codeshelf/MOUNTA/MOUNTA.45/production files/MOUNTA.45 LASERCUT README.docx

MOUNTA.45 LASERCUT README

Vendor: Ponoko

File: MOUNTA.45_X40_P2_0.193BLACK_DELRIN.eps OR MOUNTA.45_X81_P3_0.193BLACK_DELRIN.eps

Material: Delrin, Black

Thickness: 0.193 inches

Yield: 40 OR 81
