codeshelf/MOUNTA/MOUNTA.90/production files/MOUNTA.90 LASERCUT README.docx

MOUNTA.90 LASERCUT README

Vendor: Ponoko

Files: MOUNTA.90_X42_P2_0.193WHITE_DELRIN.eps OR MOUNTA.90_X91_P3_0.193WHITE_DELRIN.eps

Material: Delrin, White

Thickness: 0.193 inches

Yield: 42 OR 91
