codeshelf/MOUNTA/MOUNTA.45/production files/MOUNTA.45.BOM.xlsx

 | Product Name: | Mounting Bracket A 45 degree (VER 1.1 REV A) |  | Tag: | MOUNTA.45.v1.1
 | Product Number: | MOUNTA.45 |  | Date: | 2015-05-21
 |  |  |  | Last Updated: | 2016-01-28
Qty | Name | Description | Drawing/Part No. | Tag | Date | Supplier | Notes
2 | MOUNTA.45 | 45Degree (vertical) mounting bracket, lasercut 5mm Delrin | MOUNTA.45 | MOUNTA.45.v1.1 | 2016-01-28 | Ponoko | See README for production details
