codeshelf/MOUNTA/MOUNTA.90/production files/MOUNTA.90.BOM.xlsx

 | Product Name: | Mounting Bracket A 90 degree (VER 1.1 REV A) |  | Tag: | MOUNTA.90.v1.1
 | Product Number: | MOUNTA.90 |  | Date: | 2015-05-21
 |  |  |  | Last Updated: | 2016-01-28
Qty | Name | Description | Drawing/Part No. | Tag | Date | Supplier | Notes
2 | MOUNTA.90 | 90 Degree (vertical) mounting bracket, lasercut 5mm Delrin | MOUNTA.90 | v1.1 | 2016-01-28 | Ponoko | See README for production details
