codeshelf/MOUNTA/MOUNTA.45/Design Files/MOUNTA.V1.1.45.SLDPRT

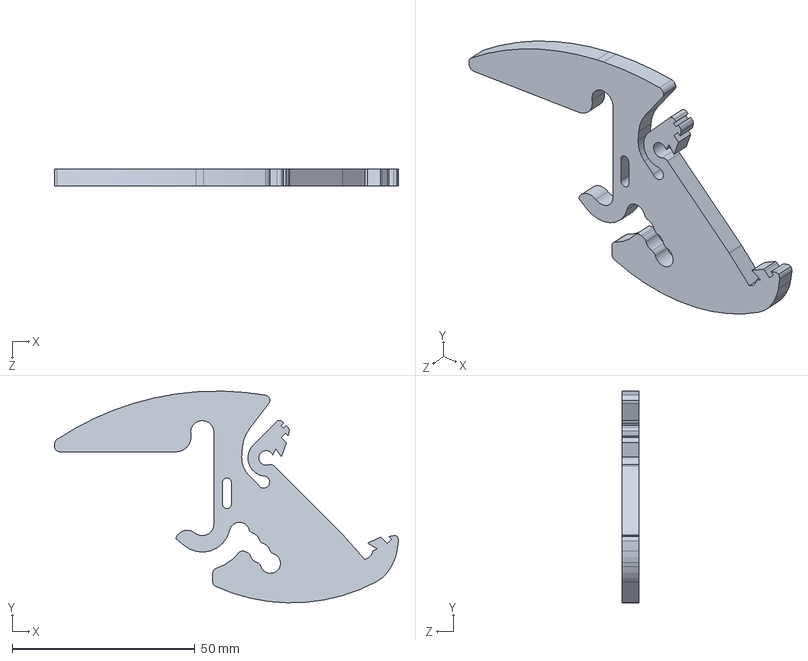
[picture p2: CAD file, 2016-02-16]
MOUNTA.45/Design Files/MOUNTA.V1.1.45.SLDPRT
94.1 x 57.9 x 4.76 mm
