codeshelf/MOUNTA/MOUNTA.90/Design Files/MOUNTA.V1.1.90.SLDPRT

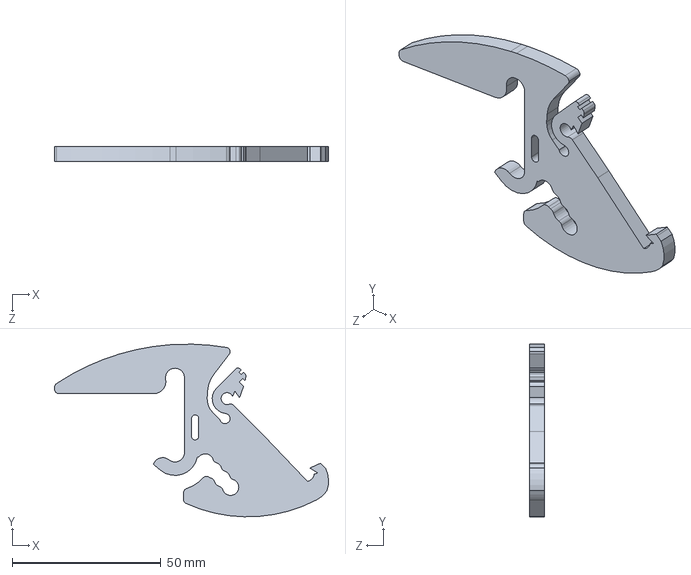
[picture p3: CAD file, 2016-01-27]
MOUNTA.90/Design Files/MOUNTA.V1.1.90.SLDPRT
91.9 x 57.9 x 4.90 mm
