codeshelf/MOUNTA/(list of files, cad)

Other CAD files:
MOUNTA.45/Design Files/MOUNTA.V1.1.45.DXF
MOUNTA.45/Design Files/MOUNTA.V1.1.45.SLDDRW
