codeshelf/MOUNTA/MOUNTA.45/production files/MOUNTA.V1.1.45.PDF

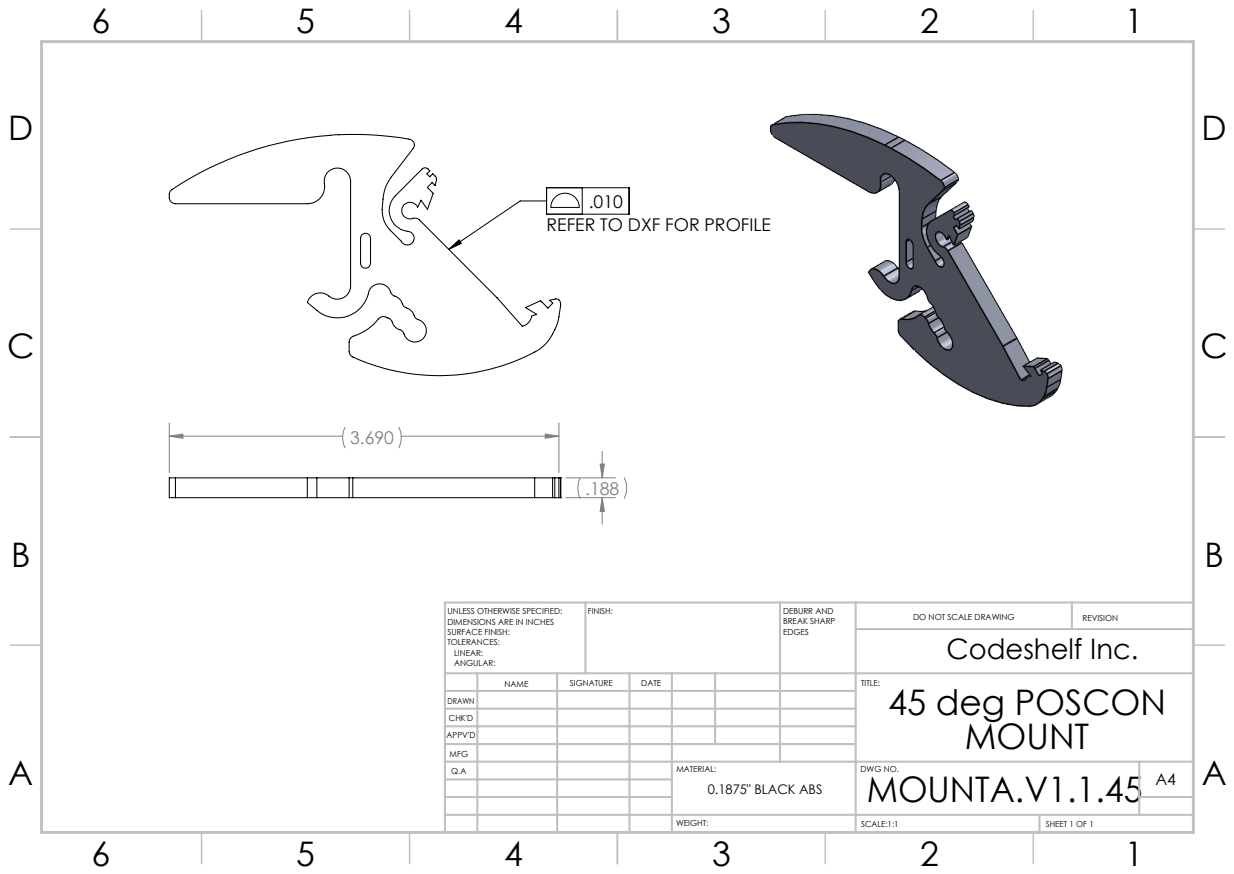
[picture p4: page 1]
FINISH:; DEBURR AND; BREAK SHARP; DO NOT SCALE DRAWING; REVISION; SCALE:1:1; SHEET 1 OF 1; Codeshelf Inc.

REFER TO DXF FOR PROFILE

UNLESS OTHERWISE SPECIFIED:
DIMENSIONS ARE IN INCHES
SURFACE FINISH:
TOLERANCES:
LINEAR:
ANGULAR:

NAME | SIGNATURE | DATE | | | | TITLE: 45 deg POSCON MOUNT

DRAWN
CHK'D
APPV'D
MFG
Q.A | | | | MATERIAL: 0.1875" BLACK ABS | DWG NO. MOUNTA.V1.1.45 | A4
