codeshelf/MOUNTA/(commit log)

2015-05-08 Added BOM documents
    [MOUNTA.45.BOM.xlsx, MOUNTA.90.BOM.xlsx]
2015-05-21 Initial file commit
    Added BOM, drawings, STEP, SLDPRT, EPS, ETC.
    [MOUNTA.45.BOM.xlsx, MOUNTA.45.SLDPRT, MOUNTA.45.STEP, MOUNTA.90.BOM.xlsx, MOUNTA.90.SLDPRT, MOUNTA.90.STEP]
2015-05-21 Update BOM, initial commit ECOs
    [MOUNTA.45.ECO.xlsx, MOUNTA.90.BOM.xlsx, MOUNTA.90.ECO.xlsx]
2016-01-27 Update for RC candidate files version 1.1
    also got rid of solid models for laser cut parts. not needed for
    production
    [MOUNTA.45.BOM.xlsx, MOUNTA.45.ECO.xlsx, MOUNTA.45.SLDPRT, MOUNTA.45.STEP, MOUNTA.90.SLDPRT, MOUNTA.90.STEP]
2016-01-27 Updated MOUNTA designs as per feedback from Zack and JR
    Mounts were breaking on install of carts and ACCU. Width between rails
    is larger than accounted for in design. Made bottom clip slightly
    thinner (4.5mm) and made sure all reliefs were large enough.
    [MOUNTA.V1.1.45.DXF, MOUNTA.V1.1.45.SLDPRT, MOUNTA.V1.1.90.SLDPRT]
2016-01-28 Layout Production files for release. BOM/ECO changes.
    [MOUNTA.45.BOM.xlsx, MOUNTA.90.BOM.xlsx, MOUNTA.90.ECO.xlsx]
2016-02-16 Update design files and drawings for waterjet
    [MOUNTA.V1.1.45.DXF, MOUNTA.V1.1.45.SLDDRW, MOUNTA.V1.1.45.SLDPRT]
